brycedjohnson/stmbl/hw/tools/stmbl4_stickers.pdf

## servoterm github.com/rene-dev/stmbl

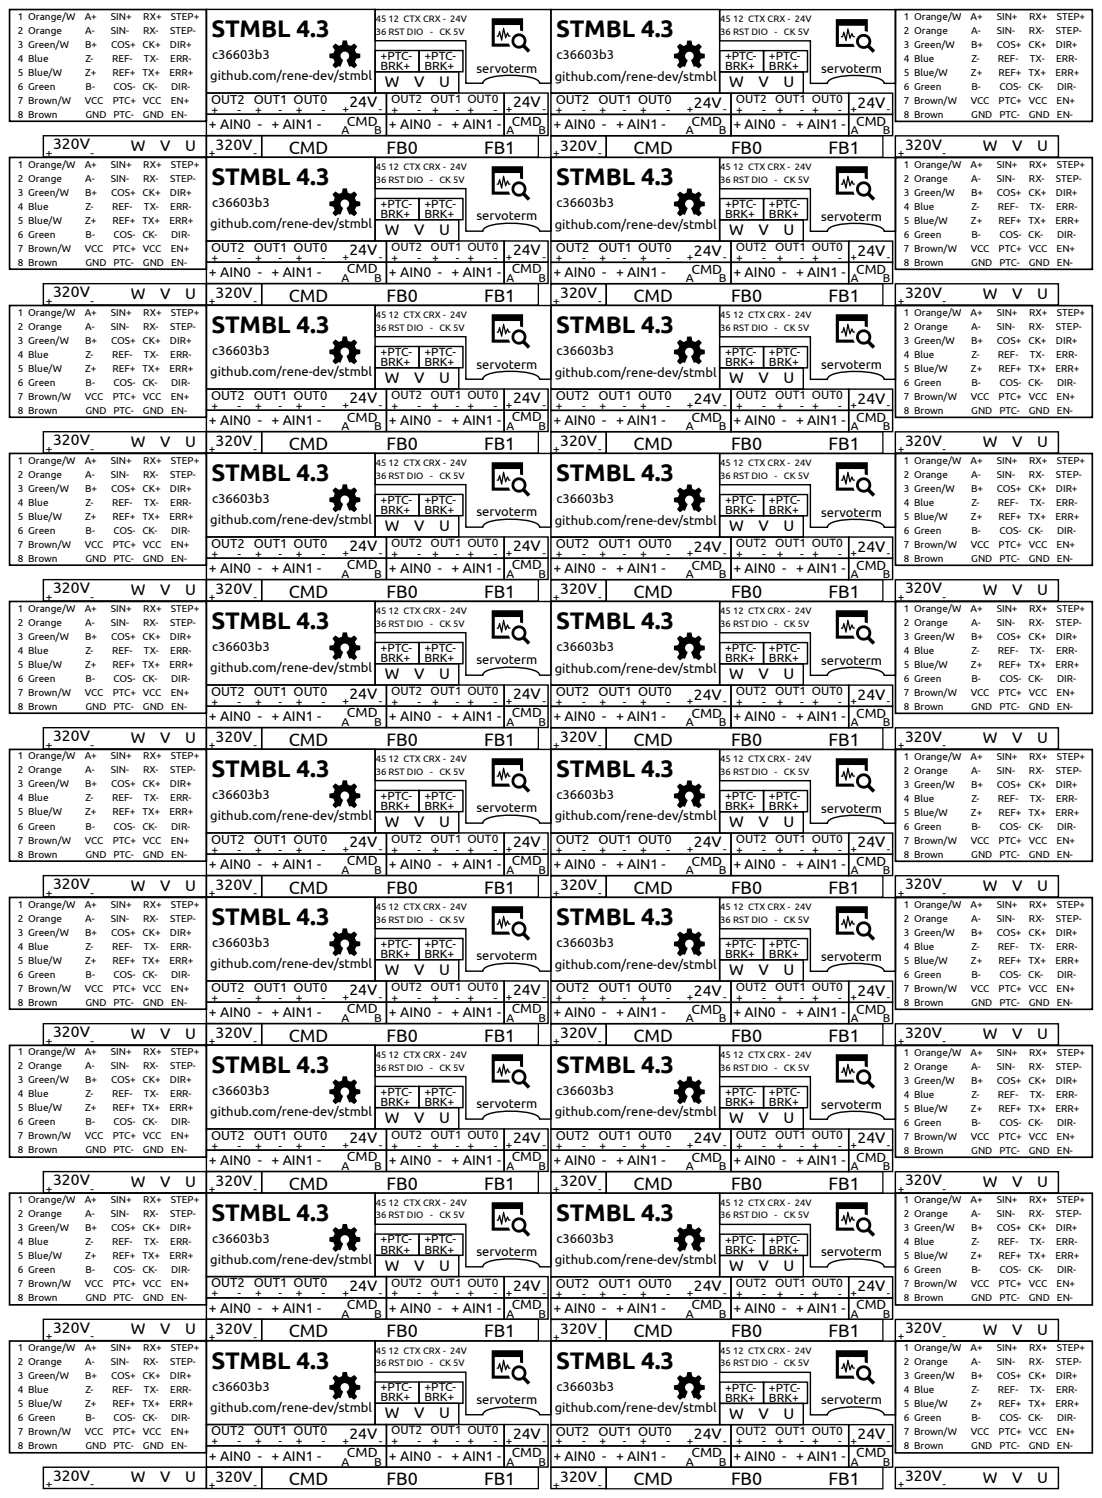
[picture p1: page 1]
1 Orange/W A+; SIN+ RX+ STEP+; 2 Orange; SIN-; RX- STEP-; 3 Green/W; COS+ CK+ DIR+; 4 Blue; REF- TX- ERR-; 5 Blue/W; REF+ TX+ ERR+; 6 Green; COS- CK-; DIR-; 7 Brown/W; VCC PTC+ VCC EN+; 8 Brown; GND PTC- GND EN-; STMBL 4.3; +PTC-; BRK+ W V U; servoterm; BRK+

45 12 CTX CRX - 24V
36 RST DIO - CK 5V

github.com/rene-dev/stmbl

OUT2 OUT1 OUT0 - + - + -- 24V + | OUT2 OUT1 OUT0 + - + - + - | + - 24V CMD ⁺ | OUT2 OUT1 OUT0 - + - + -- 24V + | OUT2 OUT1 OUT0 + - + - + - | + - 24V CMD ⁺
A CMD B + AIN0 - + AIN1 - | + AIN0 - + AIN1 - | A B | A CMD B + AIN0 - + AIN1 - | + AIN0 - + AIN1 - | A B

320V W V U + - | + 320V - | CMD FB0 FB1 | | 320V + - | CMD FB0 FB1 | 320V W V U + -

320V W V U + - | + -320V | CMD FB0 FB1 | | 320V + - | CMD FB0 FB1 | 320V W V U + -
