brycedjohnson/stmbl/hw/kicad/v4.0/stmbl_4.0.kicad_pcb

## KiCad design hw/kicad/v4.0/stmbl_4.0.kicad_pcb (2021-03-04)

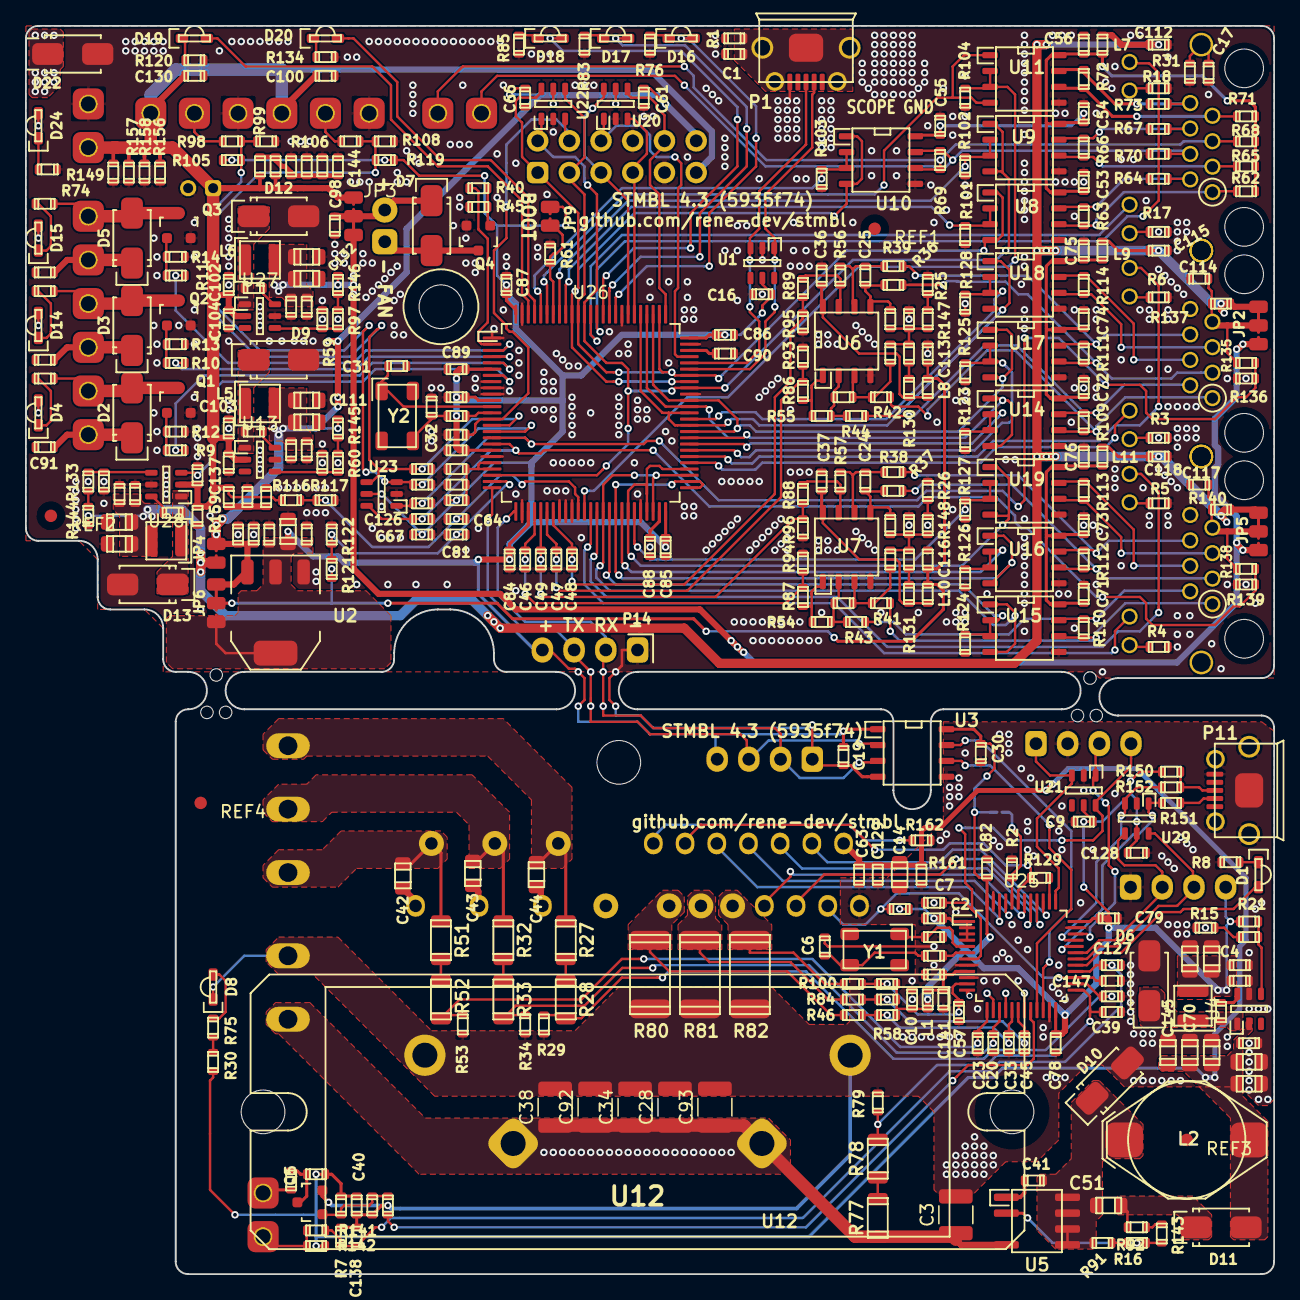
[picture p2: board stmbl_4.0.kicad_pcb from above]

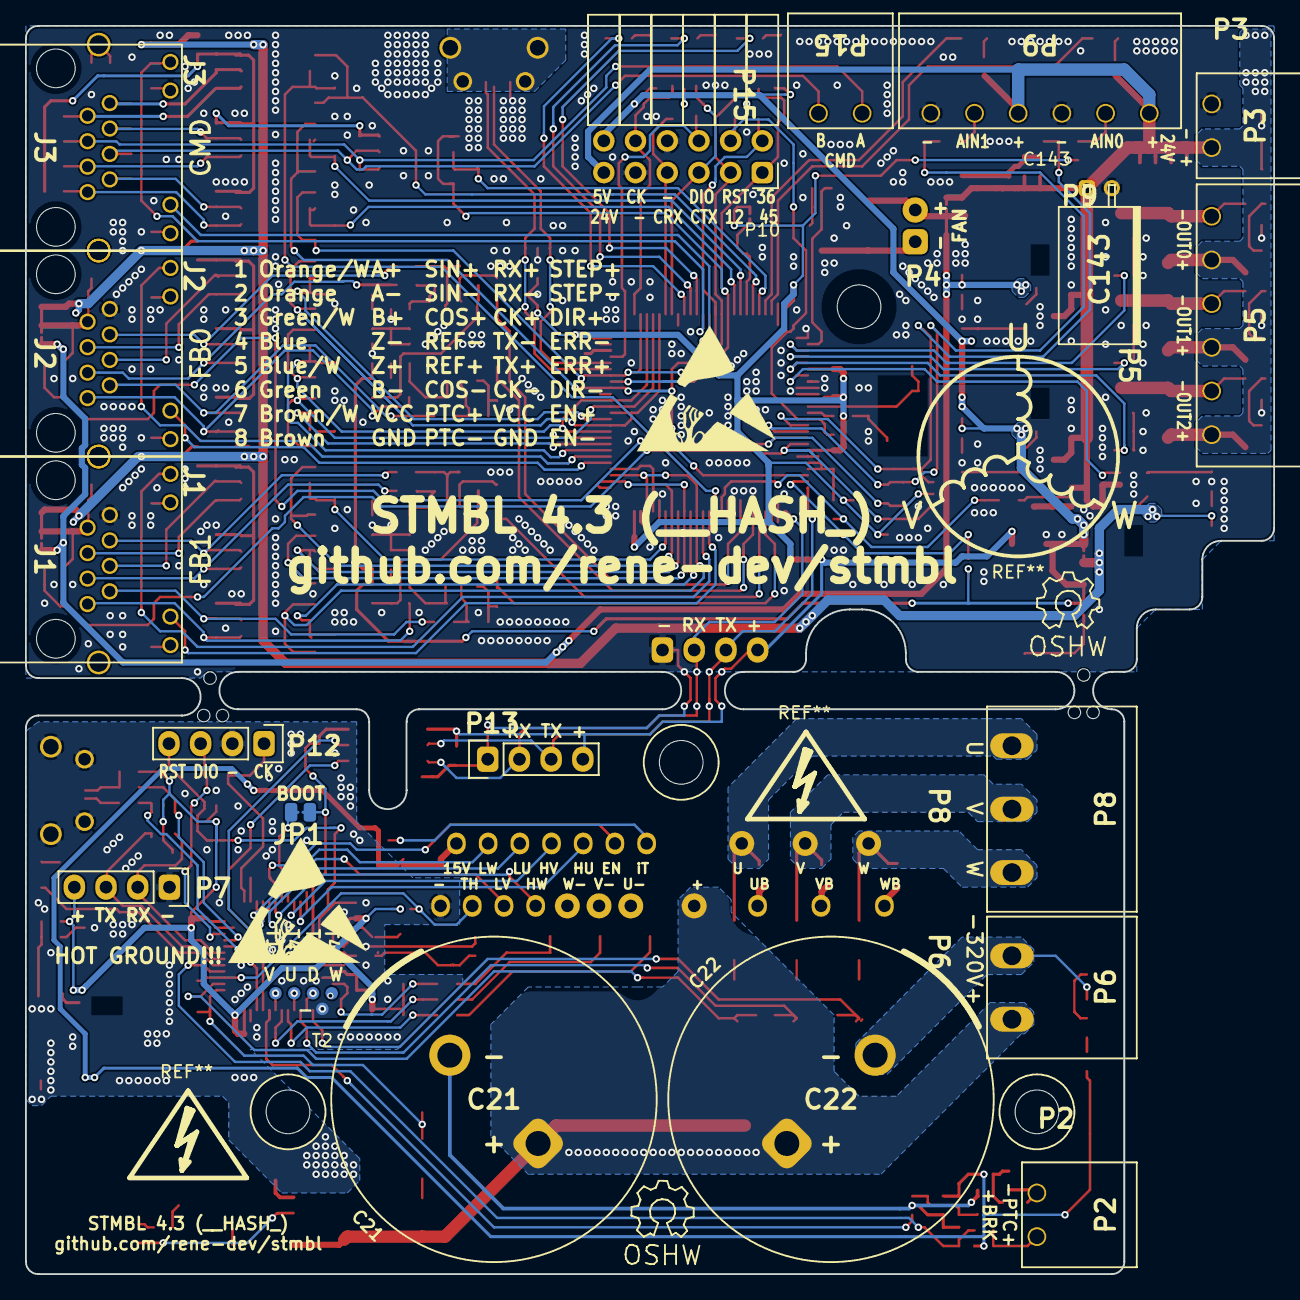
[picture p3: board stmbl_4.0.kicad_pcb from below]

Board: 2 copper layers, 100.0 x 100.0 mm, 428 parts (29 on the bottom side), 230 nets.

Parts:
C1, C2, C7, C9, C10, C12, C13, C15, C16, C17, C19, C29, C30, C36, C37, C40, C41, C53, C54, C55, C56, C58, C60, C61, C63, C66, C67, C71, C72, C73, C74, C75, C76, C77, C78, C79, C80, C82, C83, C84, C85, C86, C87, C89, C91, C94, C95, C96, C98, C99, C100, C103, C104, C105, C106, C107, C108, C112, C113, C114, C115, C116, C117, C118, C119, C120, C121, C122, C125, C126, C127, C128, C130, C138, C147: 100n; C_0603
C3, C28, C34, C38, C92, C93: 100n; C_1210_3225Metric
C4, C14, C35, C51, C68, C69, C70, C97, C109, C110, C111, C123, C124, C131, C132, C145: 10µ; C_0805
C5, C6, C11, C20, C23, C24, C25, C26, C27, C31, C32, C33, C39, C45, C57: 18p; C_0603
C8, C18, C50, C62, C65, C88, C90, C101, C102, C129, C133, C134, C135, C136, C137, C139, C140, C141, C142, C144: 2.2u; C_0603
C21, C22: 270µ; C_Radial_D26_L45_P10
C42, C43, C44: 2.2u; C_0805
C46, C47, C48, C49, C52, C59, C64, C81: 1n; C_0603
C143: 22µ; C_Radial_D6.5_L11_P2.5
D1, D16: red; LED-0805-SIDE
D2, D3, D5, D7, D10, D11: ES1J R2; SMA_Standard
D4, D8, D14, D15, D18, D19, D20, D24: green; LED-0805-SIDE
D6, D9, D12, D13: SS34A; SMA_Standard
D17: yellow; LED-0805-SIDE
D22: SMAJ24A TVS 24V; SMA_Standard
J1, J2, J3: RJ45_LED
JP1, JP4, JP9: Jumper_NO_Small; SOLDER_JUMPER
JP2, JP3, JP5, JP6: JUMPER3_NC; SOLDER_JUMPER_3_NC
L1, L3, L7, L8, L9, L10, L11: 220r 700mA; R_0603
L2: 1m 250mA; NPI31W
L4, L6: 10µH 1A; SMD_INDUCTOR_32x25
L5, L12: 4.7µH 1.5A; SMD_INDUCTOR_32x25
LOGO1, LOGO1#2: OPEN_HARDWARE_1; Symbol_OSHW-Logo_SilkScreen
P1, P11: USB_OTG; USB_Micro-B
P2, P3, P15: CONN_01X02; RM3.5_1x2
P4: CONN_01X02; Pin_Header_Angled_1x02
P5, P9: CONN_01X06; RM3.5_1x6
P6: CONN_01X02; RM5.08_1x2
P7, P12: CONN_01X04; Pin_Header_Straight_1x04
P8: CONN_01X03; RM5.08_1x3
P10: CONN_02X06; Socket_Strip_Angled_2x06
P13: CONN_01X04; Socket_Strip_Straight_1x04
P14: CONN_01X04; Pin_Header_Angled_1x04
Q1, Q2, Q3, Q4, Q5: IRLML6344; SOT-23
R1, R23, R24, R25, R26, R31, R109, R110, R111, R112, R113, R114, R130, R131: 120; R_0603
R2, R12, R13, R14, R15, R16, R30, R45, R61, R63, R66, R69, R72, R75, R91, R99, R101, R102, R103, R104, R105, R108, R117, R118, R119, R121, R122, R123, R124, R125, R126, R127, R128, R129, R136, R139, R145, R153, R162, R165: 1k; R_0603
R3, R4, R5, R6, R8, R17, R18, R46, R76, R83, R84, R85, R93, R94, R95, R96, R100, R120, R134: 470; R_0603
R7, R35, R36, R37, R38, R39, R41, R42, R43, R44, R62, R64, R65, R67, R68, R70, R71, R73, R98, R106, R115, R116, R132, R135, R137, R138, R140, R142, R155, R156, R157, R158: 10k; R_0603
R9, R10, R11, R40, R86, R87, R88, R89, R147, R148, R151, R152, R154, R159, R160, R163, R167: 22; R_0603
R19, R47, R48, R49, R50, R54, R55, R56, R57, R58, R90, R92, R107: 15k; R_0603
R20, R22, R29, R34, R53, R59, R74, R79, R144, R146, R149, R161, R164, R166: 3.9k; R_0603
R21, R60, R97, R133, R141: 51k; R_0603
R27, R28, R32, R33, R51, R52, R77, R78: 249k; R_1206
R80, R81, R82: 0.003; R_2512
R143, R150: 1.5k; R_0603
REF1, REF2, REF3, REF4: Fiducial_1mm_Dia_2.54mm_Outer_CopperTop; Fiducial_1mm_Outer_CopperTop
T1, T2, T44, T45, T46: testpoint; Measurement_Point_Round-SMD-Pad_Small
U1, U20, U21, U22, U23, U29: USBLC6-4SC6; SOT-23-6
U2: zldo1117; SOT-223
U3: SI8621; SOIC-8-N
U4, U13, U27, U28: ACT4088; SOT-23-6
U5: LNK304D; SOIC-7
U6, U7: LM358; SOIC-8-N
U8, U9, U10, U11, U14, U15, U16, U17, U18, U19: SN65176B; SOIC-8-N
U12: IRAM256a; IRAM256
U24, U30, U31, U32: non_plated; non_plated_3mm
U25: STM32F303CBTx; LQFP-48_7x7mm_Pitch0.5mm
U26: STM32F405VG; LQFP-100_14x14mm_Pitch0.5mm
U33: heatsink; non_plated_1mm
U34: fan; non_plated_1mm
U35, U36, U37, U39: non_plated; non_plated_1mm
Y1, Y2: 8M; Crystal_SMD_0503_4Pads

Connections:
+3.3VP: C2.1, C4.1, C9.1, C10.2, C30.2, C35.1, C50.1, C60.1, C78.2, C79.2, C82.2, C128.1, JP1.1, L1.2, L4.2, P7.4, R21.1, R58.2, R90.2, R107.2, R115.1, R150.2, U3.8, U21.5, U25.1, U25.2, U25.3, U25.4, U25.24, U25.36, U25.48, U29.5
+3V3: C16.2, C18.1, C19.1, C67.1, C77.2, C80.2, C84.2, C85.2, C86.2, C87.2, C89.2, C99.1, C131.1, JP6.3, JP9.1, L3.2, P13.4, P14.4, R105.1, R119.1, U1.5, U2.2, U3.1, U23.5, U26.6, U26.11, U26.19, U26.28, U26.50, U26.75, U26.100
+5F: C112.1, C115.2, C118.2, C122.1, C123.1, C124.1, C134.1, JP2.1, JP4.1, JP5.1, L7.2, L9.1, L11.1, L12.2, R137.2, R140.2, R144.1
+5V: C8.1, C61.1, C66.1, C96.1, C107.1, C109.1, C111.1, C135.1, JP4.2, JP6.1, L5.2, P10.12, R145.1, U2.3, U20.5, U22.5
+5VA: C113.2, C116.2, JP6.2, L8.1, L10.1, R121.1
+12V: C108.1, C110.1, C132.1, C136.1, JP2.3, JP3.1, JP5.3, L6.2, R146.1
+15V: C14.2, C40.2, C58.1, C63.1, C68.1, C69.1, C70.1, C97.1, C129.1, C145.1, D11.2, L2.2, R30.1, R142.1, R161.1, R164.1, R166.1, U4.2, U12.28
+24V: C91.1, C94.1, C95.1, C100.1, C102.1, C103.1, C104.1, C120.1, C130.1, C133.1, C137.1, C143.1, D2.1, D3.1, D4.2, D5.1, D14.2, D15.2, D22.1, D24.2, JP3.3, P3.1, P5.1, P5.3, P5.5, P9.1, P9.4, P10.11, R116.1, R154.1, R155.1, R156.1, R157.1, R158.1, R159.1, R160.1, U13.2, U27.2, U28.2
/ctrl/FB0/A12: C47.1, R86.1, R93.1, U26.31
/ctrl/FB0/A35: C48.1, R89.1, R95.1, U26.32
/ctrl/FB0/A78: C125.1, R135.2, R136.1, U23.1, U26.17
/ctrl/FB0/D12: U14.1, U14.4, U26.59, U26.64, U26.79
/ctrl/FB0/D36: U17.1, U17.4, U26.60, U26.65, U26.78
/ctrl/FB0/D45: U18.1, U18.4, U26.61, U26.63, U26.80
/ctrl/FB0/E12: R123.1, U14.2, U14.3, U26.58
/ctrl/FB0/E36: R125.1, U17.2, U17.3, U26.57
/ctrl/FB0/E45: R128.1, U18.2, U18.3, U26.62
/ctrl/FB1/A12: C46.1, R87.1, R94.1, U26.29
/ctrl/FB1/A35: C49.1, R88.1, R96.1, U26.30
/ctrl/FB1/A78: C126.1, R138.2, R139.1, U23.6, U26.18
/ctrl/FB1/D12: U15.1, U15.4, U26.40, U26.48, U26.53
/ctrl/FB1/D36: U16.1, U16.4, U26.42, U26.51, U26.52
/ctrl/FB1/D45: U19.1, U19.4, U26.44, U26.47, U26.54
/ctrl/FB1/E12: R124.1, U15.2, U15.3, U26.41
/ctrl/FB1/E36: R126.1, U16.2, U16.3, U26.43
/ctrl/FB1/E45: R127.1, U19.2, U19.3, U26.45
/ctrl/IO/CAN_RX: P10.7, U20.3, U26.81
/ctrl/IO/CAN_TX: P10.5, U20.6, U26.82
/ctrl/IO/IO_FAN: R40.2, U26.2
/ctrl/IO/IO_GREEN: D18.2, U26.86
/ctrl/IO/IO_L0: D19.2, U26.98
/ctrl/IO/IO_L1: D20.2, U26.97
/ctrl/IO/IO_OUT0: R11.2, U26.3
/ctrl/IO/IO_OUT1: R10.2, U26.4
/ctrl/IO/IO_OUT2: R9.2, U26.5
/ctrl/IO/IO_RED: D16.2, U26.84
/ctrl/IO/IO_YELLOW: D17.2, U26.85
/ctrl/IO/NRST: C29.2, P10.4, U22.3, U26.14
/ctrl/IO/SWCK: P10.10, U20.4, U26.76
/ctrl/IO/SWDIO: P10.6, U20.1, U26.72
/ctrl/RX: P13.2, P14.2, U3.3, U26.26
/ctrl/TX: P13.3, P14.3, U3.2, U26.25
/ctrl/f4/A_5V: C81.1, R121.2, R122.1, U26.24
/ctrl/f4/A_24V: C64.1, R116.2, R117.1, U26.36
/ctrl/f4/CMD_12: P10.3, U8.1, U8.4, U22.4, U26.69, U26.77, U26.90
/ctrl/f4/CMD_12E: R101.1, U8.2, U8.3, U26.92
/ctrl/f4/CMD_36: P10.2, U9.1, U9.4, U22.1, U26.23, U26.67, U26.89
/ctrl/f4/CMD_36E: R102.1, U9.2, U9.3, U26.93
/ctrl/f4/CMD_45: P10.1, U10.1, U10.4, U22.6, U26.68, U26.91
/ctrl/f4/CMD_45E: R103.1, U10.2, U10.3, U26.96
/ctrl/f4/CMD_78: U11.1, U11.4, U26.95
/ctrl/f4/CMD_78E: R104.1, U11.2, U11.3, U26.37
/ctrl/f4/CMD_L1: J3.12, U26.88
/ctrl/f4/CMD_L2: J3.10, U26.87
/ctrl/f4/EN_5V: U26.7, U28.3
/ctrl/f4/FB0_L1: J2.12, U26.55
/ctrl/f4/FB0_L2: J2.10, U26.56
/ctrl/f4/FB1_L1: J1.12, U26.38
/ctrl/f4/FB1_L2: J1.10, U26.39
/ctrl/f4/IO_AIN0: C52.1, R98.2, R99.1, R105.2, U23.4, U26.15
/ctrl/f4/IO_AIN1: C59.1, R106.2, R108.1, R119.2, U23.3, U26.16
/hv/back-emf/U: C44.1, P8.1, R27.1, U12.10
/hv/back-emf/V: C43.1, P8.2, R32.1, U12.6
/hv/back-emf/W: C42.1, P8.3, R51.1, U12.2
/hv/cur/A_IU: C33.1, R46.1, R58.1, U25.17
/hv/cur/A_IV: C45.1, R84.1, R90.1, U25.18
/hv/cur/A_IW: C57.1, R100.1, R107.1, U25.11
/hv/driver/CUH: R46.2, R80.1, U12.17
/hv/driver/CVH: R81.1, R84.2, U12.19
/hv/driver/CWH: R82.1, R100.2, U12.21
/hv/driver/HU: U12.20, U25.46
/hv/driver/HV: U12.22, U25.45
/hv/driver/HW: U12.23, U25.42
/hv/driver/LU: U12.24, U25.41
/hv/driver/LV: U12.25, U25.40
/hv/driver/LW: U12.26, U25.39
/hv/driver/itirp: R162.1, U12.16
/hv/f3/A_HV: C39.1, R78.2, R79.1, U25.25
/hv/f3/A_T_HV: C147.1, R115.2, U12.27, U25.27
/hv/f3/A_T_MOT: C127.2, C138.2, R7.2, R141.2, U25.28
/hv/f3/A_U: C11.1, R28.2, R29.1, U25.26
/hv/f3/A_V: C20.1, R33.2, R34.1, U25.15
/hv/f3/A_W: C23.1, R52.2, R53.1, U25.13
/hv/f3/BRK: R163.1, U25.20
/hv/f3/HV_EN: R129.1, U12.18, U25.43
/hv/f3/HV_RX: U3.7, U25.22
/hv/f3/HV_TX: U3.6, U25.21
/hv/f3/IO_RX: P7.2, U25.31, U29.4
/hv/f3/IO_TX: P7.3, U25.30, U29.6
/hv/f3/NRST: C7.1, P12.4, U21.6, U25.7
/hv/f3/SWCLK: P12.1, U21.3, U25.37
/hv/f3/SWDIO: P12.3, U21.1, U25.34
/hv/f3/USB_DM: R151.1, U25.32, U29.1
/hv/f3/USB_DP: R152.1, U25.33, U29.3
GND: C1.2, C8.2, C12.2, C13.2, C16.1, C17.2, C18.2, C19.2, C29.1, C31.2, C32.2, C36.1, C37.1, C46.2, C47.2, C48.2, C49.2, C52.2, C53.2, C54.2, C55.2, C56.2, C59.2, C61.2, C62.2, C64.2, C65.1, C66.2, C67.2, C71.2, C72.2, C73.2, C74.2, C75.2, C76.2, C77.1, C80.1, C81.2, C84.1, C85.1, C86.1, C87.1, C88.2, C89.1, C90.2, C91.2, C94.2, C95.2, C96.2, C98.2, C99.2, C100.2, C101.2, C102.2, C103.2, C104.2, C107.2, C108.2, C109.2, C110.2, C111.2, C112.2, C113.1, C114.2, C115.1, C116.1, C117.2, C118.1, C119.1, C120.2, C122.2, C123.2, C124.2, C125.2, C126.2, C130.2, C131.2, C132.2, C133.2, C134.2, C135.2, C136.2, C137.2, C139.2, C140.2, C142.2, C143.2, C144.2, D9.2, D12.2, D13.2, D22.2, J1.8, J2.8, P1.5, P3.2, P9.3, P9.6, P10.8, P10.9, P13.1, P14.1, Q1.2, Q2.2, Q3.2, Q4.2, R1.2, R3.2, R4.2, R5.2, R6.2, R12.2, R13.2, R14.2, R17.2, R18.2, R25.2, R26.2, R31.2, R35.2, R45.2, R59.2, R61.1, R64.2, R67.2, R70.2, R73.2, R76.2, R83.2, R85.2, R93.2, R94.2, R95.2, R96.2, R99.2, R101.2, R102.2, R103.2, R104.2, R108.2, R117.2, R120.2, R122.2, R123.2, R124.2, R125.2, R126.2, R127.2, R128.2, R132.2, R134.2, R136.2, R139.2, R149.2, R155.2, R156.2, R157.2, R158.2, U1.2, U2.1, U3.4, U6.4, U7.4, U8.5, U9.5, U10.5, U11.5, U13.5, U14.5, U15.5, U16.5, U17.5, U18.5, U19.5, U20.2, U22.2, U23.2, U26.1, U26.8, U26.9, U26.10, U26.20, U26.27, U26.33, U26.34, U26.35, U26.46, U26.66, U26.74, U26.83, U26.99, U27.5, U28.5
GNDD: C17.1, J1.13, J2.13, J3.13, R31.1
GNDPWR: C2.2, C3.2, C4.2, C5.2, C6.2, C7.2, C9.2, C10.1, C11.2, C14.1, C20.2, C21.2, C22.2, C23.2, C28.2, C30.1, C33.2, C34.2, C35.2, C38.2, C39.2, C40.1, C45.2, C50.2, C57.2, C58.2, C60.2, C63.2, C68.2, C69.2, C70.2, C78.1, C79.1, C82.1, C83.1, C92.2, C93.2, C97.2, C127.1, C128.2, C129.2, C138.1, C141.1, C145.2, C147.2, D6.2, D8.1, D10.2, P6.1, P7.1, P11.5, P11.6, P12.2, Q5.2, R2.2, R7.1, R8.1, R15.2, R29.2, R34.2, R53.2, R79.2, R80.2, R81.2, R82.2, R161.2, R162.2, R165.2, T2.1, U3.5, U4.5, U12.29, U21.2, U25.8, U25.10, U25.23, U25.35, U25.47, U29.2
unnamed: C1.1, P1.6, R1.1
unnamed: C5.1, U25.5, Y1.1
unnamed: C6.1, R118.2, Y1.2
unnamed: C12.1, R23.2, R48.1, R49.1, R148.1
unnamed: C13.1, R24.2, R47.1, R50.1, R147.1
unnamed: C15.1, U4.6
unnamed: C15.2, D6.1, L4.1, U4.1
unnamed: C24.1, R37.1, R49.2, U7.5
unnamed: C24.2, R38.1, R57.2, U7.6
unnamed: C25.1, R36.1, R50.2, U6.5
unnamed: C25.2, R39.1, R56.2, U6.6
unnamed: C26.1, R41.1, R48.2, U7.3
unnamed: C26.2, R43.1, R54.2, U7.2
unnamed: C27.1, R42.1, R47.2, U6.3
unnamed: C27.2, R44.1, R55.2, U6.2
unnamed: C31.1, U26.12, Y2.1
unnamed: C32.1, R153.2, Y2.2
unnamed: C36.2, L8.2, R130.1, U6.8
unnamed: C37.2, L10.2, R131.1
unnamed: C41.1, U5.1
unnamed: C41.2, C51.2, D10.1, L2.1, R91.1, U5.5, U5.6, U5.7, U5.8
unnamed: C42.2, U12.1
unnamed: C43.2, U12.5
unnamed: C44.2, U12.9
unnamed: C51.1, D11.1, R92.2
unnamed: C53.1, C54.1, C55.1, C56.1, L7.1, R62.1, R65.1, R68.1, R71.1, U8.8, U9.8, U10.8, U11.8
unnamed: C71.1, C73.1, C76.1, L11.2, U15.8, U16.8, U19.8
unnamed: C72.1, C74.1, C75.1, L9.2, U14.8, U17.8, U18.8
unnamed: C88.1, U26.49
unnamed: C90.1, U26.73
unnamed: C98.1, D7.1, JP3.2, P4.2
unnamed: C62.1, C101.1, R159.2
unnamed: C105.1, U13.6
unnamed: C105.2, D9.1, L5.1, U13.1
unnamed: C106.1, U27.6
unnamed: C106.2, D12.1, L6.1, U27.1
unnamed: C114.1, J2.7, JP2.2, R135.1, R137.1
unnamed: C117.1, J1.7, JP5.2, R138.1, R140.1
unnamed: C65.2, C119.2, L3.1, U26.21, U26.22
unnamed: C121.1, U28.6
unnamed: C121.2, D13.1, L12.1, U28.1
unnamed: C139.1, C140.1, C142.1, C144.1, R154.2, R160.2
unnamed: C83.2, C141.2, L1.1, U25.9
unnamed: D1.1, R8.2
unnamed: D1.2, U25.29
unnamed: D2.2, P5.2, Q1.3, R20.2
unnamed: D3.2, P5.4, Q2.3, R22.2
unnamed: D4.1, R20.1
unnamed: D5.2, P5.6, Q3.3, R74.2
unnamed: D7.2, P4.1, Q4.3
unnamed: D8.2, R75.2
unnamed: D14.1, R22.1
unnamed: D15.1, R74.1
unnamed: D16.1, R76.1
unnamed: D17.1, R83.1
unnamed: D18.1, R85.1
unnamed: D19.1, R120.1
unnamed: D20.1, R134.1
unnamed: D24.1, R149.1
unnamed: J1.1, R41.2, R110.1, U15.6
unnamed: J1.2, R43.2, R110.2, U15.7
unnamed: J1.3, R37.2, R112.1, U16.6
unnamed: J1.4, R113.2, U19.7
unnamed: J1.5, R113.1, U19.6
unnamed: J1.6, R38.2, R112.2, U16.7
unnamed: J1.9, R5.1
unnamed: J1.11, R4.1
unnamed: J2.1, R42.2, R109.1, U14.6
unnamed: J2.2, R44.2, R109.2, U14.7
unnamed: J2.3, R36.2, R111.1, U17.6
unnamed: J2.4, R114.2, U18.7
unnamed: J2.5, R114.1, U18.6
unnamed: J2.6, R39.2, R111.2, U17.7
unnamed: J2.9, R6.1
unnamed: J2.11, R3.1
unnamed: J3.1, R62.2, R63.1, U8.6
unnamed: J3.2, R63.2, R64.1, U8.7
unnamed: J3.3, R65.2, R66.1, U9.6
unnamed: J3.4, P15.2, R69.2, R70.1, U10.7
unnamed: J3.5, P15.1, R68.2, R69.1, U10.6
unnamed: J3.6, R66.2, R67.1, U9.7
unnamed: J3.7, R71.2, R72.1, U11.6
unnamed: J3.8, R72.2, R73.1, U11.7
unnamed: J3.9, R18.1
unnamed: J3.11, R17.1
unnamed: JP1.2, R2.1, U25.44
unnamed: JP9.2, R61.2, U26.94
unnamed: P1.2, U1.1, U26.70
unnamed: P1.3, U1.3, U26.71
unnamed: P2.1, R141.1, R142.2
unnamed: P2.2, R167.2
unnamed: P9.2, R98.1
unnamed: P9.5, R106.1
unnamed: P11.2, R151.2
unnamed: P11.3, R150.1, R152.2
unnamed: Q1.1, R9.1, R12.1
unnamed: Q2.1, R10.1, R13.1
unnamed: Q3.1, R11.1, R14.1
unnamed: Q4.1, R40.1, R45.1
unnamed: Q5.1, R163.2, R164.2, R165.1
unnamed: Q5.3, R166.2, R167.1
unnamed: R15.1, R19.2
unnamed: R16.1, R91.2
unnamed: R19.1, R21.2, U4.4
unnamed: R27.2, R28.1
unnamed: R30.2, R75.1
unnamed: R32.2, R33.1
unnamed: R35.1, R60.2, U13.4
unnamed: R51.2, R52.1
unnamed: R54.1, R87.2, U7.1
unnamed: R55.1, R86.2, U6.1
unnamed: R56.1, R89.2, U6.7
unnamed: R57.1, R88.2, U7.7
unnamed: R59.1, R97.2, U27.4
unnamed: R77.2, R78.1
unnamed: R118.1, U25.6
unnamed: R129.2, U25.38
unnamed: R24.1, R130.2
unnamed: R23.1, R131.2
unnamed: R132.1, R133.2, U28.4
unnamed: R133.1, R144.2
unnamed: R16.2, R143.1, U5.2
unnamed: R92.1, R143.2
unnamed: R60.1, R145.2
unnamed: R97.1, R146.2
unnamed: R25.1, R147.2
unnamed: R26.1, R148.2
unnamed: R153.1, U26.13
unnamed: T1.1, U25.19
unnamed: T44.1, U25.12
unnamed: T45.1, U25.14
unnamed: T46.1, U25.16
VPP: C3.1, C21.1, C22.1, C28.1, C34.1, C38.1, C92.1, C93.1, P6.2, R77.1, U5.4, U12.13
