brycedjohnson/stmbl/(commit log)

2020-10-23 Added stickers for connectors and sheet metal case
2020-10-23 Added LCSC # to parts in 4.3 PCB
    [cmd.sch, ctrl.sch, cur.sch, f3.sch, f4.sch, fb.sch, hv.sch, hv_drive.sch]
2021-02-18 WIP LCSC
    [cmd.sch, ctrl.sch, cur.sch, f3.sch, f4.sch, fb.sch, hv.sch, hv_drive.sch]
2021-02-19 update TVS LCSC part number
    [cmd.sch, ctrl.sch, cur.sch, f3.sch, f4.sch, fb.sch, hv_drive.sch, hv_sense.sch]
2021-02-19 Changed 120uf 1808 to 1210 100uF
    [cmd.sch, f3.sch, f4.sch, fb.sch, hv.sch, hv_drive.sch, hv_supply.sch, io.sch]
2021-02-20 Switch some 2.2uf 0603 to 1uf bypass to get 50V version on jlcpcb
    Change 2.2uf 0603 to 0805 on iram to get 50V version on jlcpcb
    other cleanup
    [cmd.sch, ctrl.sch, cur.sch, f3.sch, f4.sch, fb.sch, hv.sch, hv_drive.sch]
2021-03-03 couple other PCB changes
    [stmbl_4.0.kicad_pcb]
2021-03-04 Change Crystals to right footprint
    [f3.sch, f4.sch, fb.sch, stmbl_4.0.kicad_pcb]
